Snow014/Epaper_WeatherStation/Images/E-WWS-UI.png

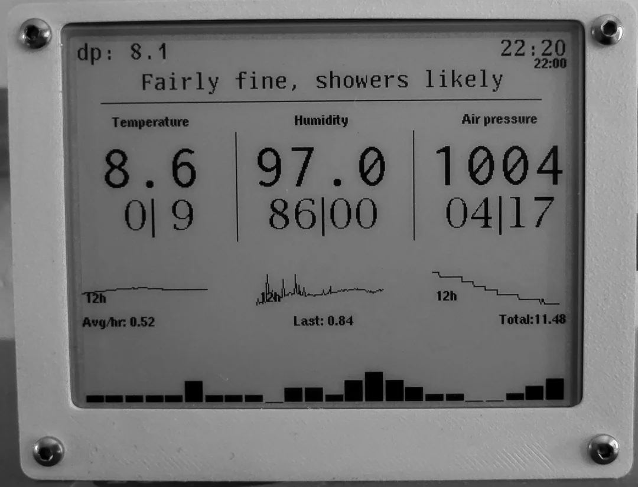
Images/E-WWS-UI.png
