Snow014/Epaper_WeatherStation/Rain_probe/Schematic/Rain_probe_schem.pdf

## I2C pullups Optional

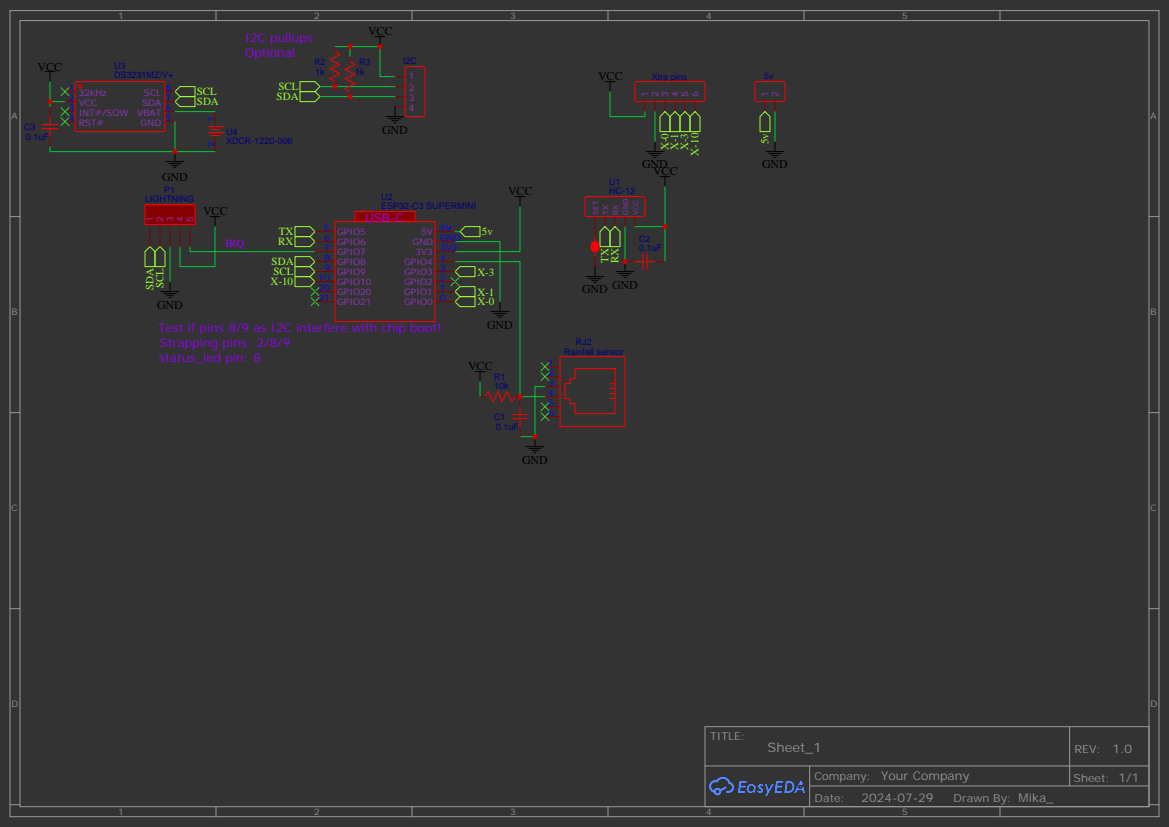
[picture p3: page 1]

GND
Test if pins 8/9 as I2C interfere with chip boot!
Strapping pins: 2/8/9
status_led pin: 8
