Snow014/Epaper_WeatherStation/Reciever/Schematic/WWS_reciever_schem.pdf

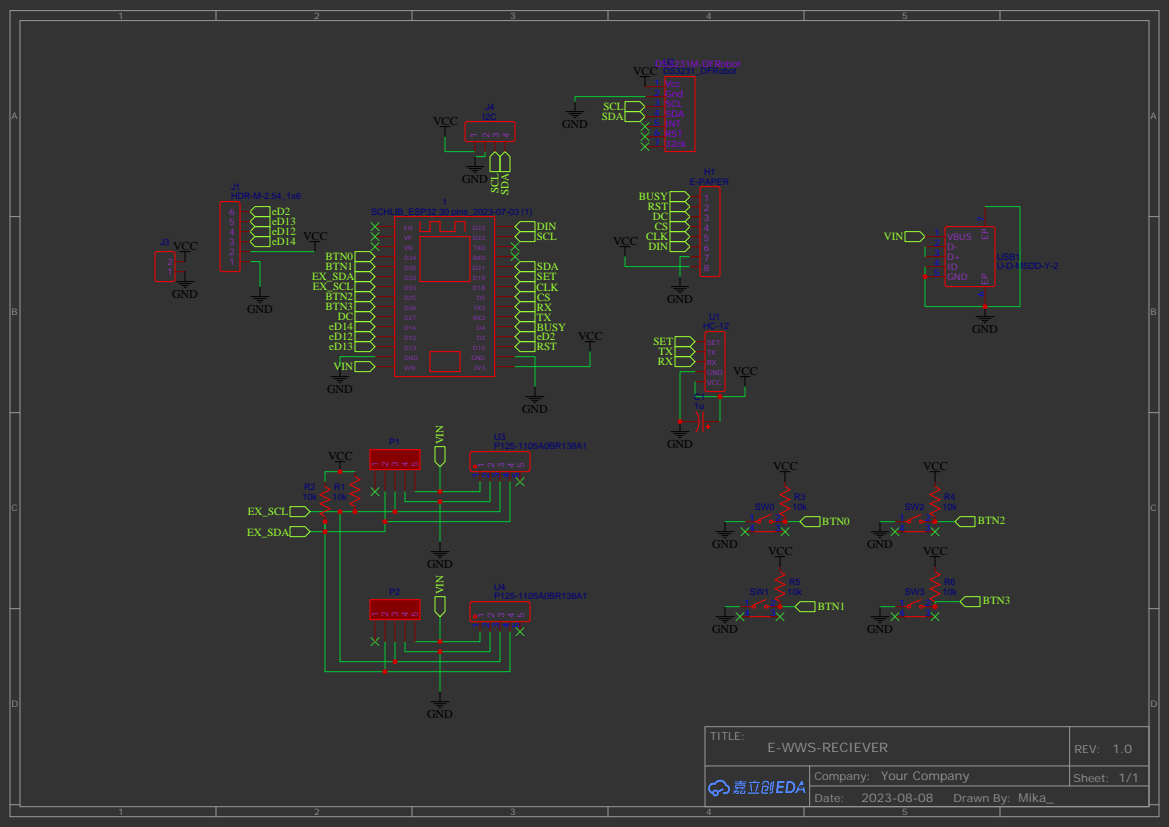
[picture p4: page 1]
