Snow014/Epaper_WeatherStation/Sender/Schematic/E-WWS-Sender.pdf

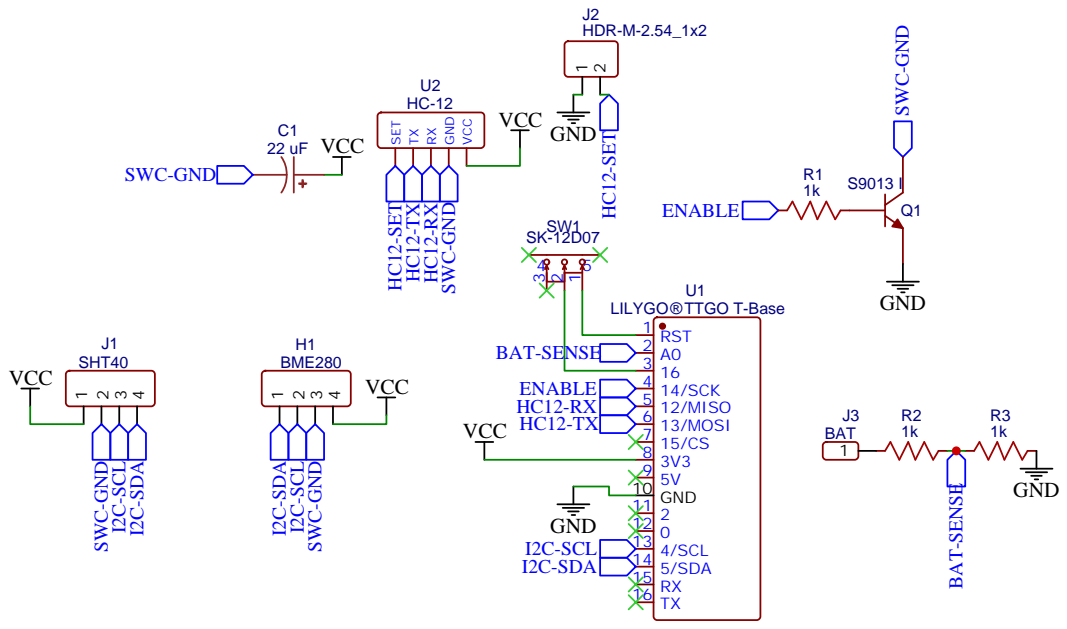
[picture p5: page 1]
