Snow014/Epaper_WeatherStation/(commit log)

2024-02-21 Added PCB gerber files
2024-02-21 Added Rain probe data
2024-03-08 Added schematics
2024-03-08 added rainprobe schematic
2024-04-18 bugfixes in zambretti function
    [E_PAPER_WEATHERSTATION_OTA_RAIN.ino]
2024-10-06 update reviecer PCB
